judjdigj/LeonardoTaiko/pics/board.jpg

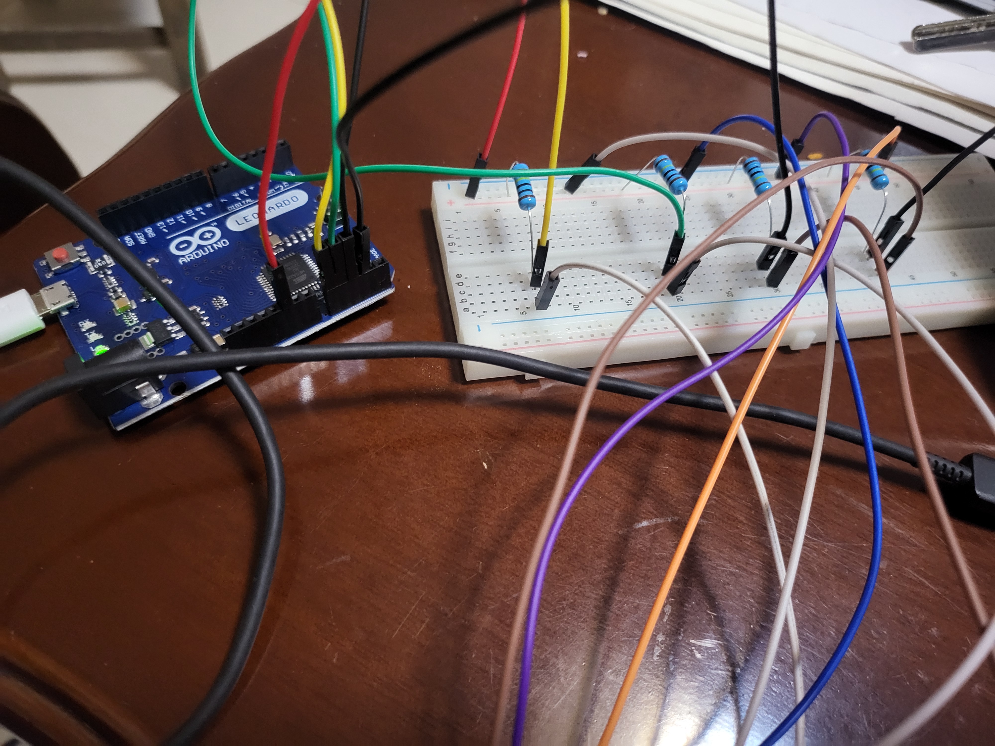
pics/board.jpg
