judjdigj/LeonardoTaiko/pics/VideoCapture_20240221-155025.jpg

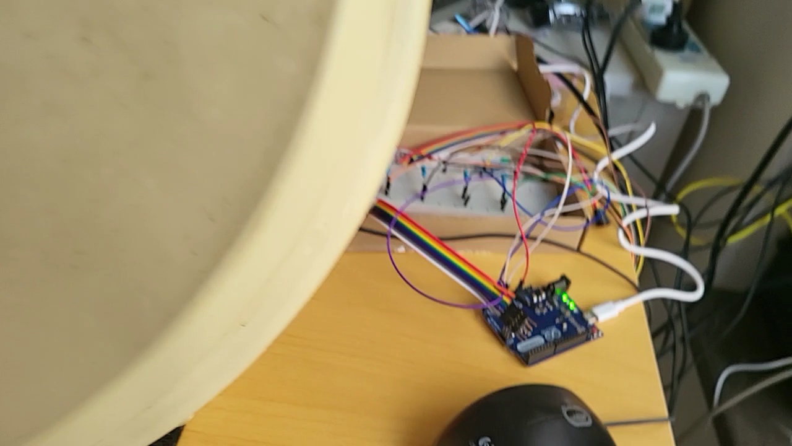
pics/VideoCapture_20240221-155025.jpg
