judjdigj/LeonardoTaiko/(commit log)

2024-02-11 Update sketch_feb8a.ino
    switch support and dynamite threshold imported
2024-02-11 更新 README.md
2024-02-21 更新 README_CN.md
2024-03-12 添加delay对齐到每秒120帧
2024-03-12 改为对齐到240帧
2024-03-12 添加多档帧对齐
2024-03-12 改为480帧对齐
2024-03-15 注释掉无用代码
2024-06-14 fix readme and some bugs
    [LeonardoTaiko.ino]
2024-06-14 Update LeonardoTaiko.ino
    fix bugs
    [LeonardoTaiko.ino]
2024-08-12 async io on switch test
2024-08-12 Revert "async io on switch test"
    This reverts commit db9796052f425a80013fc520b4d6e6eca180355a.
    [LeonardoTaiko.ino]
2024-09-25 Update LeonardoTaiko.ino
    fix right ka mis-input issue
    [LeonardoTaiko.ino]
2025-03-24 Fix async code for switch
    [LeonardoTaiko.ino]
2025-12-10 NewLeonardo updates
    Added an whole different methods to handle trigger detection. Might be unstable and need more adjusting.
    [LeonardoTaiko.ino, NewLeonardoTaiko.ino]
